yhan0117/bi_rotor/README.md

# Bi/-rotor control

Control of a planar analog of a quadcopter
