yhan0117/bi_rotor/src/control/sysID/moi/MOI.jpg

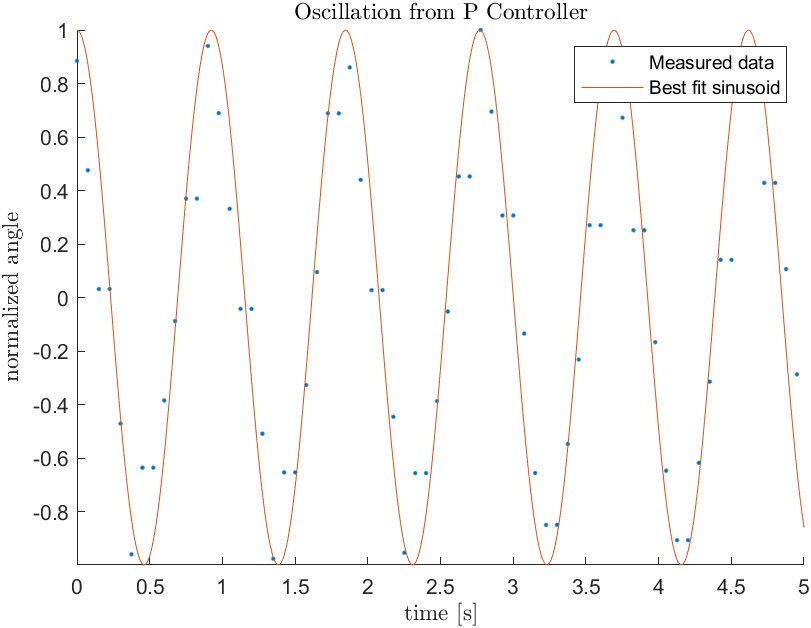
src/control/sysID/moi/MOI.jpg
