yhan0117/bi_rotor/src/control/sysID/motor/plots/CCW.jpg

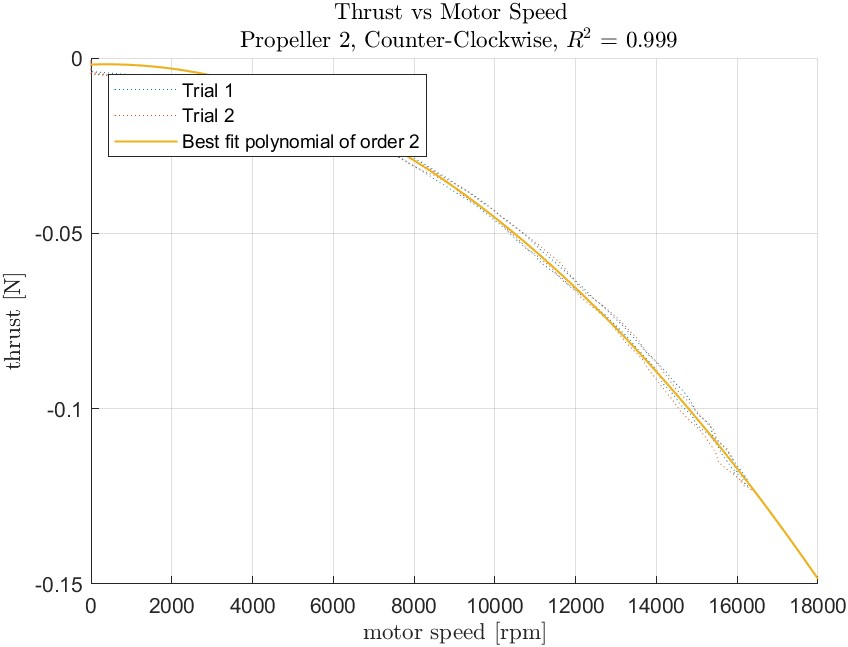
src/control/sysID/motor/plots/CCW.jpg
