yhan0117/bi_rotor/src/control/sysID/motor/plots/CCWTorque.jpg

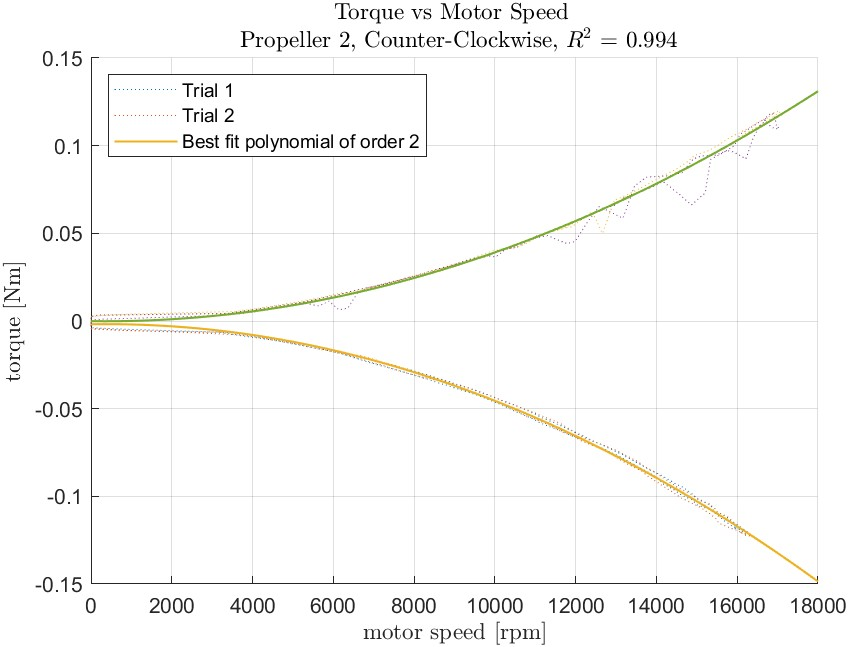
src/control/sysID/motor/plots/CCWTorque.jpg
