yhan0117/bi_rotor/src/control/sysID/motor/plots/CW.jpg

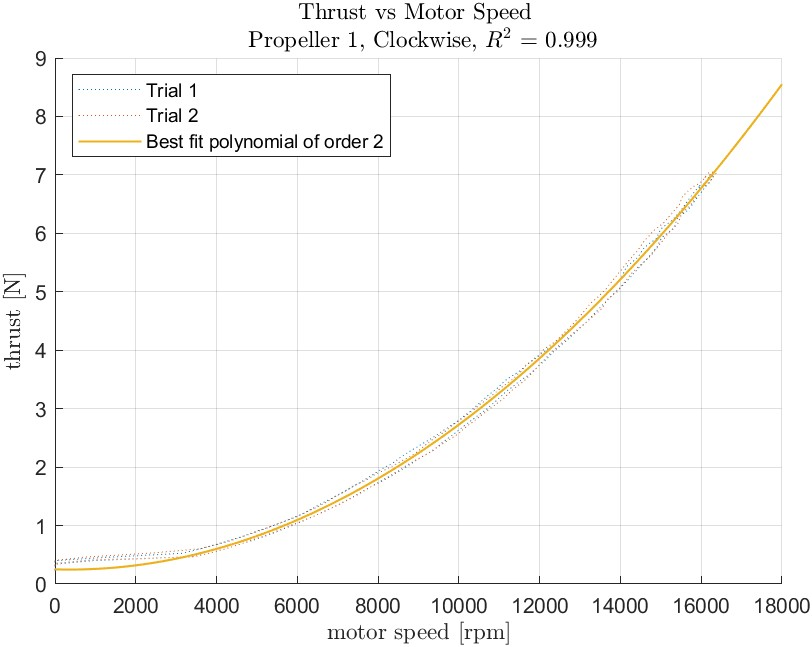
src/control/sysID/motor/plots/CW.jpg
