yhan0117/bi_rotor/src/control/sysID/motor/plots/CWTorque.jpg

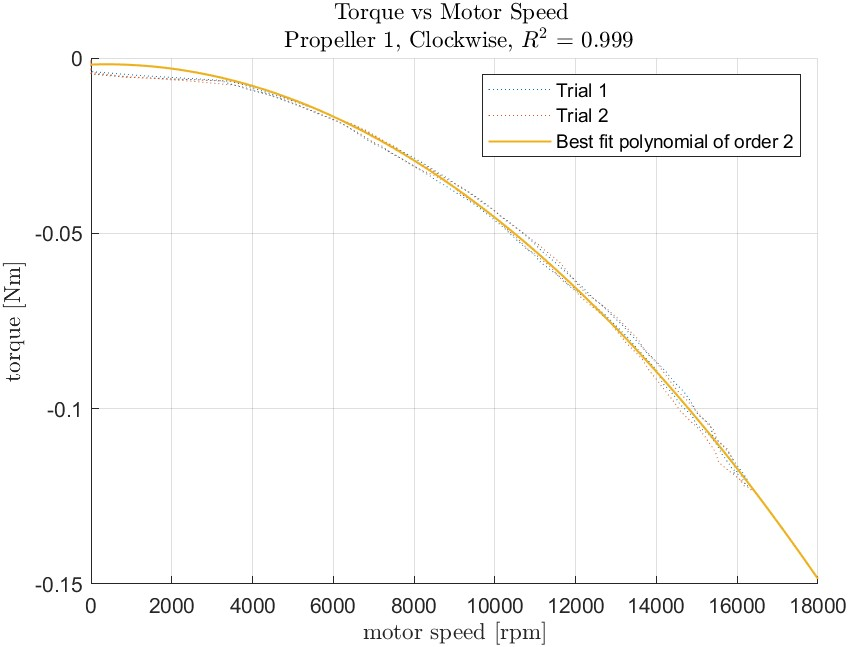
src/control/sysID/motor/plots/CWTorque.jpg
