yhan0117/bi_rotor/src/cad/ASM.SLDASM

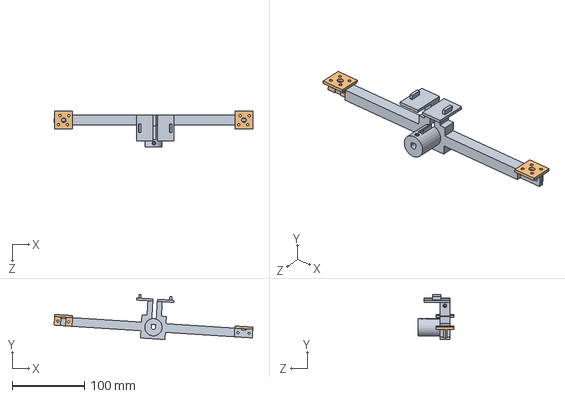
[picture p12: CAD file, 2023-08-27]
src/cad/ASM.SLDASM
275.4 x 62.4 x 49.5 mm
arm-Aneohaseyo
motor mount x 2
