yhan0117/bi_rotor/src/cad/printFiles/encoder mount.STL

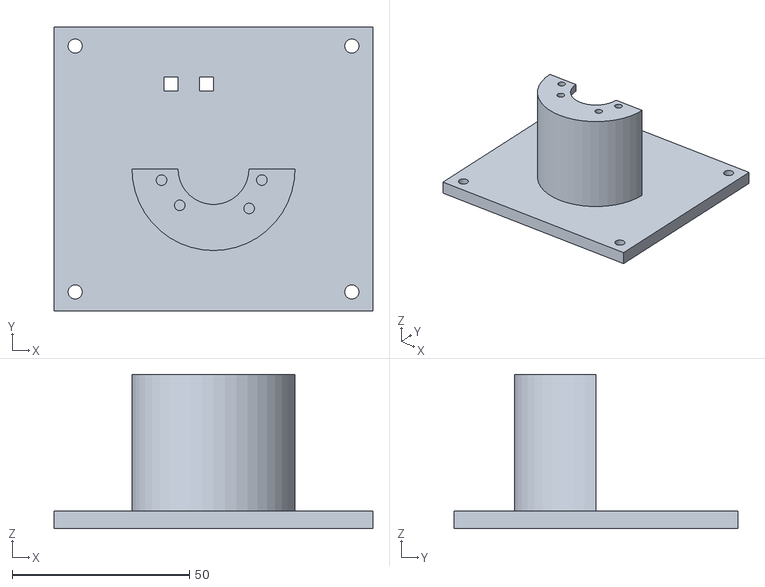
[picture p13: CAD file, 2023-08-27]
src/cad/printFiles/encoder mount.STL
90.0 x 80.0 x 43.5
