yhan0117/bi_rotor/src/cad/arm.SLDPRT

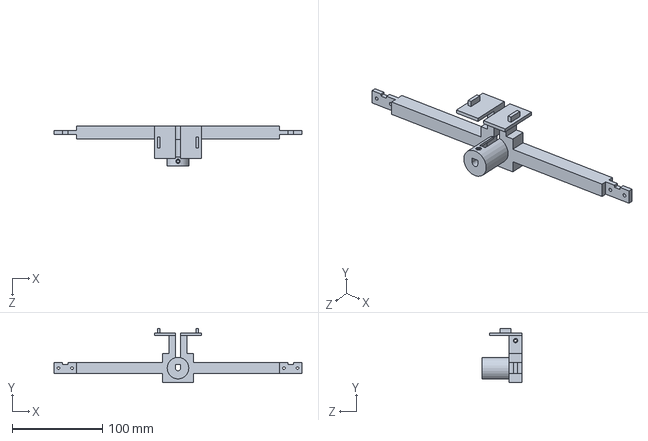
[picture p14: CAD file, 2023-08-27]
src/cad/arm.SLDPRT
275.0 x 60.0 x 44.0 mm
