yhan0117/bi_rotor/src/cad/printFiles/motor mount.STL

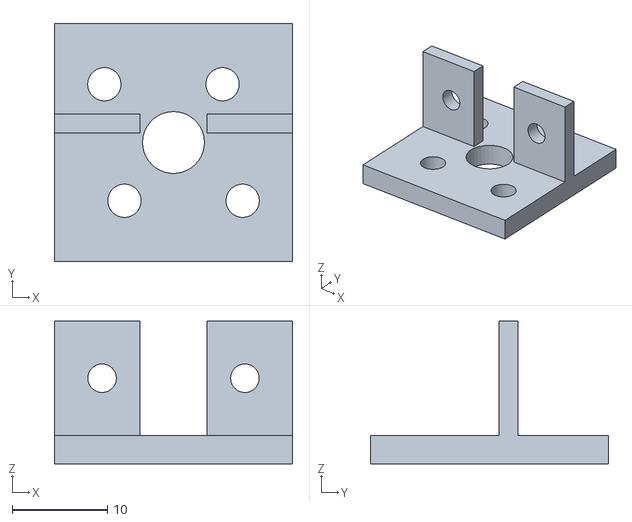
[picture p15: CAD file, 2023-08-27]
src/cad/printFiles/motor mount.STL
25.0 x 25.0 x 15.0
