yhan0117/bi_rotor/src/cad/mount.SLDPRT

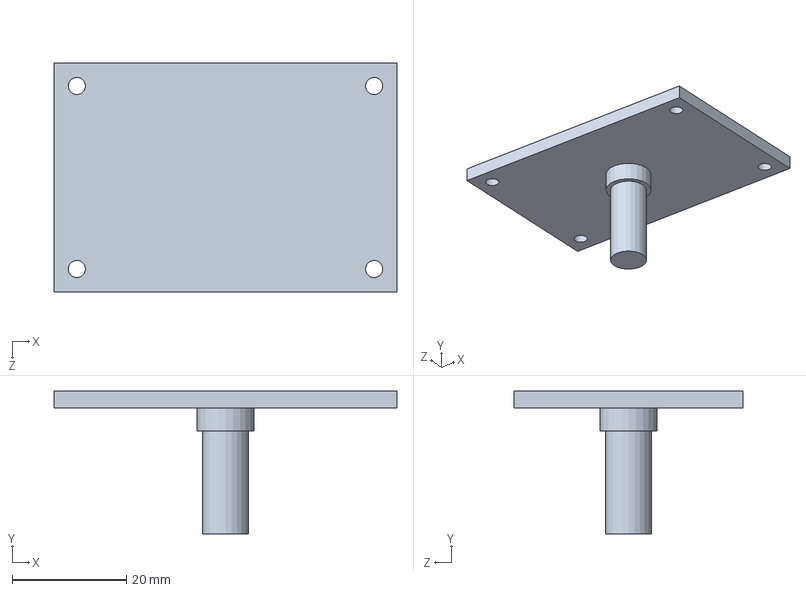
[picture p16: CAD file, 2023-08-27]
src/cad/mount.SLDPRT
60.0 x 25.0 x 40.0 mm
