yhan0117/bi_rotor/(list of files, cad)

Other CAD files:
src/cad/encoder.SLDPRT
src/cad/motor.SLDPRT
src/cad/printFiles/arm.STL
src/cad/printFiles/mount.STL
